Hauke12345/ECP5-modified/docs/images/render3d_bot_before_after.jpg

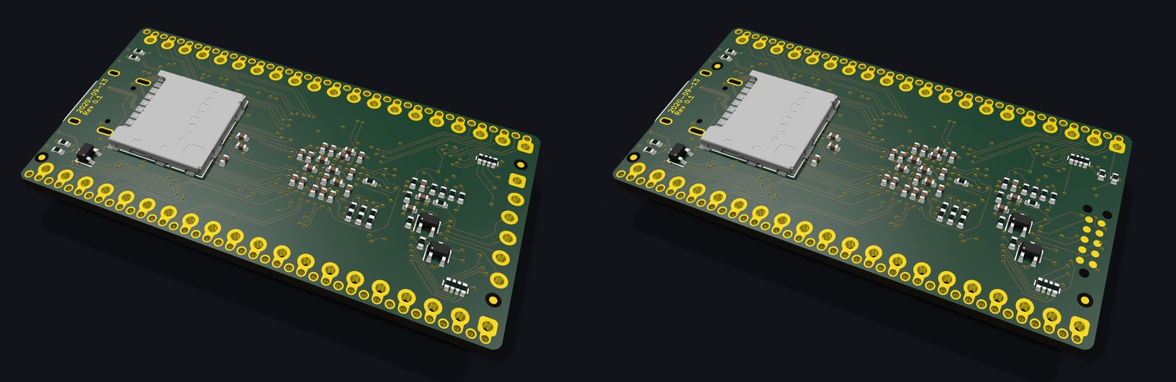
docs/images/render3d_bot_before_after.jpg
